noahportnoy/team-otto/website/Original/images/skiing.jpg

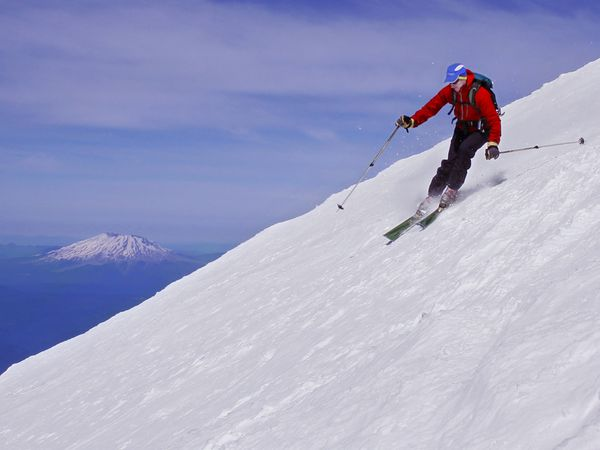
website/Original/images/skiing.jpg
