noahportnoy/team-otto/website/images/albion_png.png

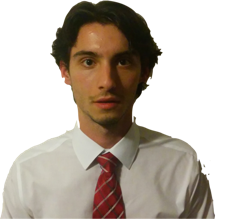
website/images/albion_png.png
