noahportnoy/team-otto/README.md

Team Otto
========

Otto - the personal Cameraman. 
-----------------------------

Otto is a drone that will follow and record you while performing action sports. Whether it be surfing, skiing, or mountain biking! Otto follows the user by fusing camera tracking data with GPS information from the user's smart phone and local GPS unit.

For more info visit: [Team Otto](http://www.ecs.umass.edu/ece/sdp/sdp15/team07/index.html)
