noahportnoy/team-otto/website/docs/Otto_MDR.pdf

# Midway Design Review

# Team Otto

November 25, 2014

# The Team

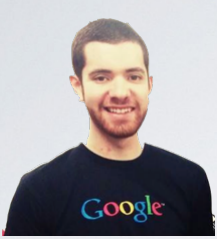
[picture p7: figure]
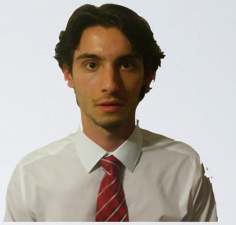
[picture p8: figure]

Noah Portnoy, CSE | Albion Lici, CSE

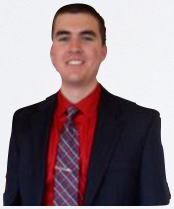
[picture p9: figure]
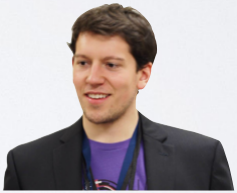
[picture p10: figure]

Seth Kielbasa, CSE | Andrew Sousa, EE

# Our System

Otto - The Personal Videographer
- Quadcopter for recording individual action sports
- Autonomous flight
- FollowMe (Tracking)

Evaluator Concerns
- Societal impact
- No collision avoidance or drone-drone communication
- What is different about Otto?

# System Requirements

### 1. Track user through a fusion of two sensors: GPS and camera 2. Collect GPS location of user with WiFi connection to user

device

### 3. Collect finer location data of user through camera tracking

4. Carry out user takeoff and landing commands
5. Maintain a user-defined drone/user separation distance
6. Allow user to start and stop video recording
7. Video recording is high-definition (720p or better)

### 8. Must maintain visual lock on user for duration of recording

9. Must take preliminary measures upon reaching critical battery level 10.Safety lock in hardware and software

# System Specifications

## 1. Maximum drone/user separation: 30 meters

## 2. Minimum drone/user separation: 5 meters 3. Average flight time: 10 minutes

## 4. Max velocity of drone: 30 mph 5. Max angular velocity of 1.8 rad/sec (103°/sec) 6. All-up mass must be less than 1.5 kg 7. Must lift at least 1.5 kg at 50% throttle

# Otto Block Diagram

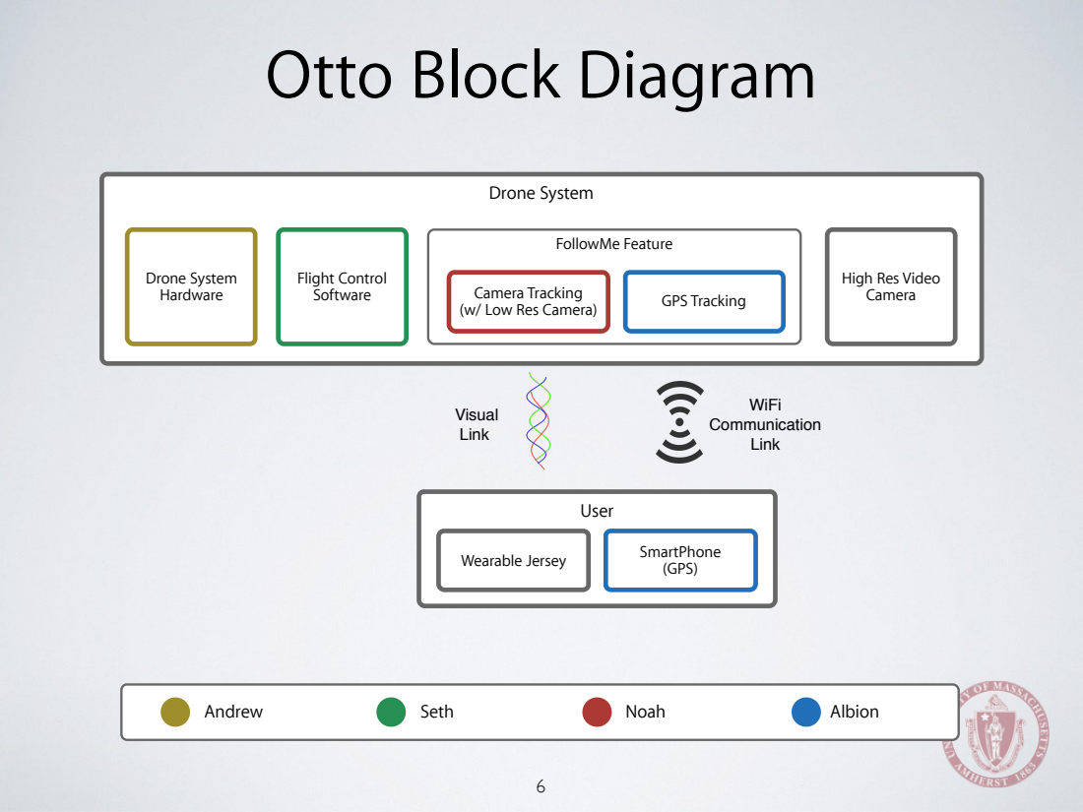
[picture p11: page 6]
User; Andrew; Seth; Noah; Albion; WiFi Communication Link; SmartPhone; Visual Link; Drone System; Flight Control Software; FollowMe Feature; Drone System Hardware

High Res Video
Camera

GPS Tracking Camera Tracking
(w/ Low Res Camera)

(GPS) Wearable Jersey

# Drone System Hardware - Data

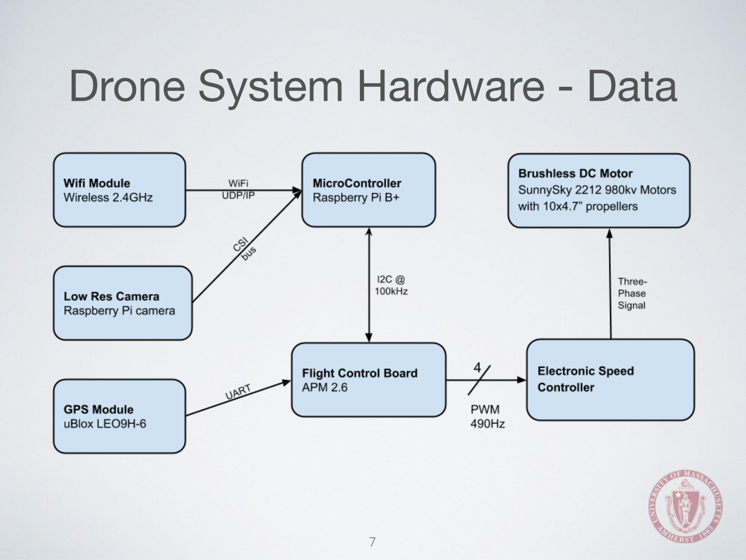
[picture p12: page 7]

# Drone System Hardware - Power

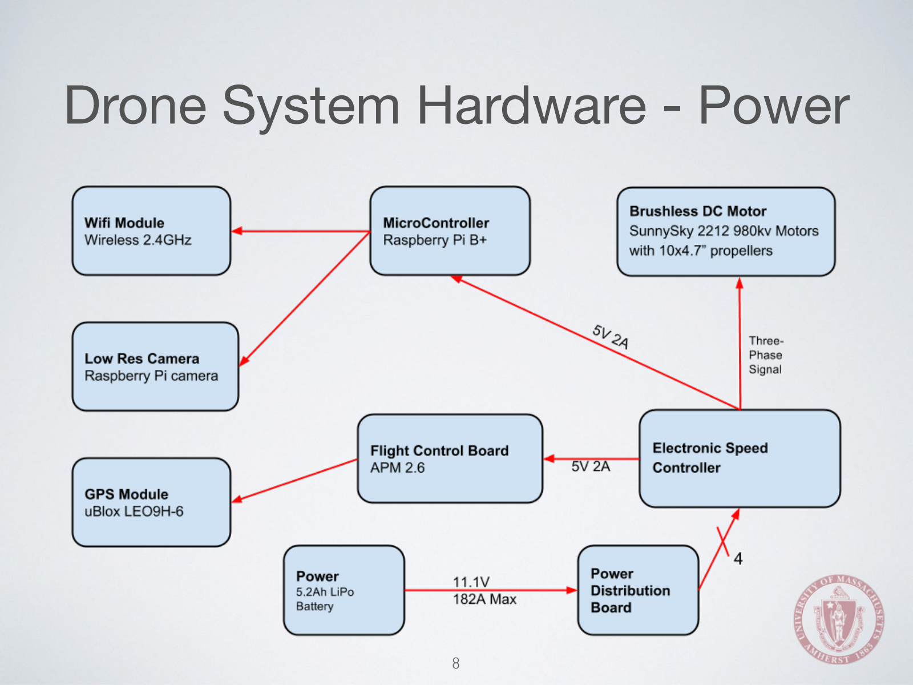
[picture p13: page 8]

# Drone System Hardware

## Requirements

## - Power system with 11.1V for 10 minutes - Must lift at least 1.5 kg at 50% throttle - Interface all devices together

## Accomplished

## - All of the above in prototype form

# Flight Control Software

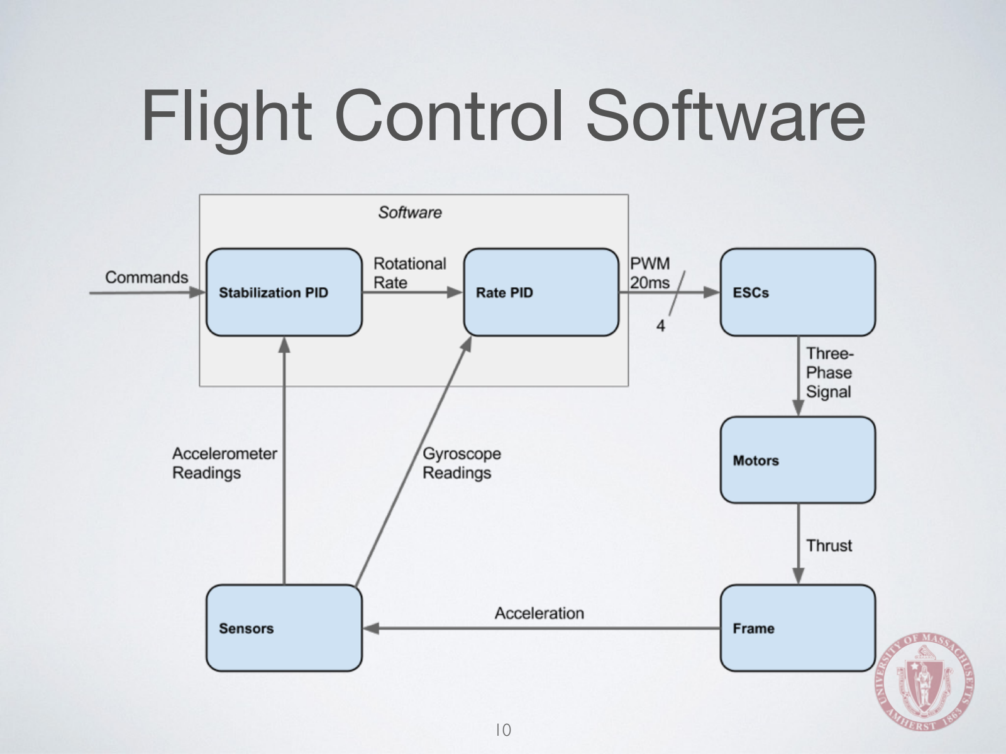
[picture p14: page 10]

# Flight Control Software

Requirements
- Read sensor data
- Feed flight control algorithm
- Send speed updates to ESCs

Accomplished
- Demonstrated ability to accurately read accelerometers and gyroscopes
- Implemented PID algorithm to make fast decisions on motor updates
- Successful test flights via manual RC control

# GPS Tracking

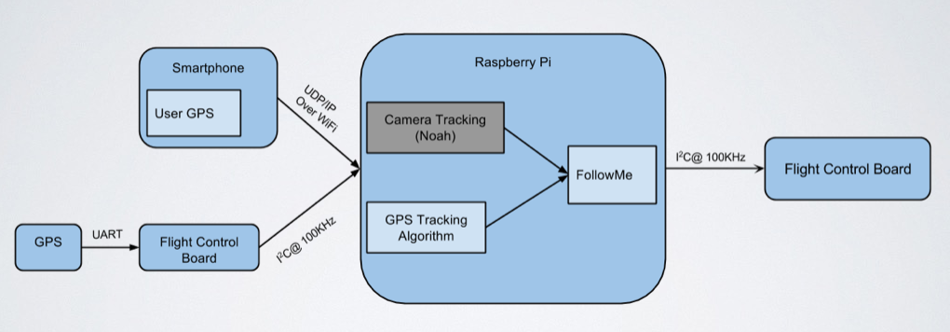
[picture p15: figure]

# GPS Tracking

Requirements
- GPS+WiFi module on drone and user’s smartphone
- WiFi running @ 2.4Ghz
- Maximum of 30 meter separation between the two WiFi modules

Accomplished
- Establish WiFi and I2C link
- Exchange coordinates between WiFi+I2C Link @ 2Hz
- Output separation between drone and user on smartphone

# Camera Tracking

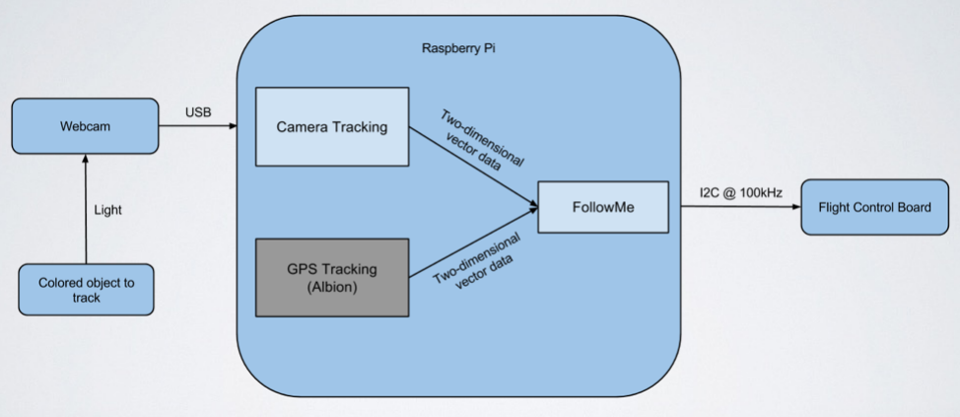
[picture p16: figure]

# Camera Tracking

Requirements
- Use low-resolution video camera
- Perform color-based object tracking
- Send commands to flight control software

Accomplished
- Color-based object tracking on Raspberry Pi
- Executes at 7.5 fps
- Detects when object is moving out of frame
- Sends yaw commands to servo to keep object in frame

# FollowMe Requirements

1. Synthesize GPS tracking and camera tracking inputs
2. Perform weighted average of inputs based on each system’s confidence metric
3. Output commands to flight control board over I2C
4. Visually lock onto user upon takeoff
5. Maintain visual lock on user for duration of recording

# CDR Deliverables

# Functional prototype

# - Autonomous flight - FollowMe Feature - Record user

# Timeline

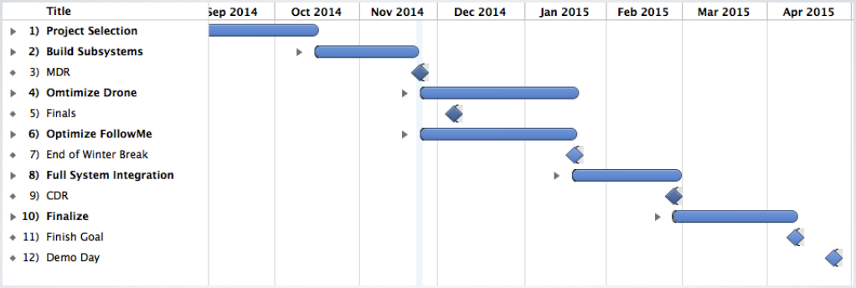
[picture p17: figure]

# Timeline

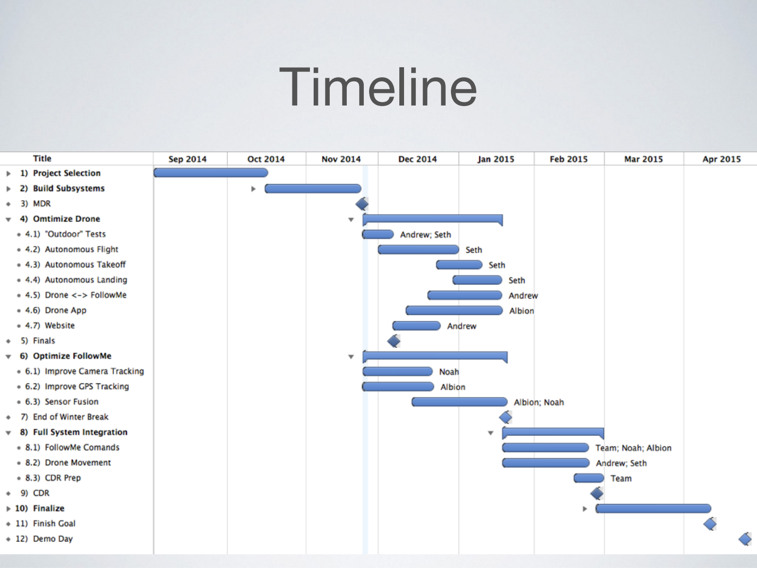
[picture p18: page 19]

# Demonstration

# Build Drone Flight Algorithm GPS Tracking Camera Tracking

# Build Drone Flight Algorithm GPS Tracking Camera Tracking

Thank you.

# Questions?

# Backup Slides

# Societal Impact

Positive | Negative
Ability to have a unique aerial 3rd person view of yourself | Could capture other people in recordings (without their knowledge of who the drone belongs to)
Ability to be followed by a quadcopter which could execute task for you | “Bad guys” could use this technology to follow people (could be discreet; could use GPS from phone)
Image processing on our system enables excellent tracking of user | Technology could be used to locate and track certain people (who do not want to be located)
This product will open our eyes to the many possibilities of what drones can do | “Bad guys” could use our platform for invasion of privacy, or even physical attacks
Technology could be leveraged in other areas such as medical, military, etc. | Could be used maliciously in a military or medical context

# Stretch Goals

## - Live video feed - Camera tracking, no wearable jersey required - Stabilize camera with a gimbal - Obstacle avoidance - Backwards recording

# Collision Avoidance

- Infrared Receivers
- Not a great option
- Earth’s surface receives IR energy from the sun
- Unreliable due to operating environment
- Ultrasonic sensors
- Maxbotix Sonar Range Finder
- Range: 0 - 21ft
- Price: 25 each
- http://www.pololu.com/product/726/resources

# Drone-Drone Communication

## - Not considering the multi-user for our prototype

# Power

## - Battery - 5200mAh lipo - 35C = 35*5.2A = 182A of Const. Current - Max burst current = 70C = 364A

## - Battery Voltage: 11.1 < V < 12.3

## - BEC on ESC output 5V @ 2A max per ESC

# Angular Velocity

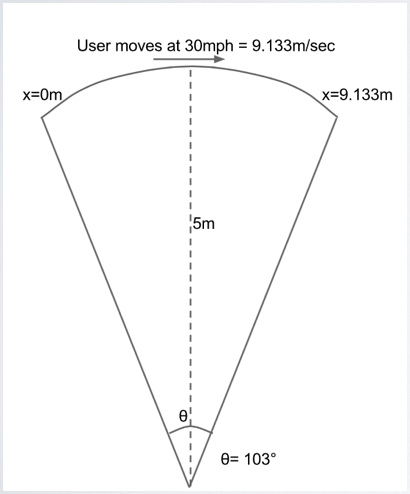
[picture p19: figure]

θ= length of subtended arc / radius

θ= 1.8 rad == 103°

⍵ = θ/t == 1.8 rad/sec

# Drone Hardware

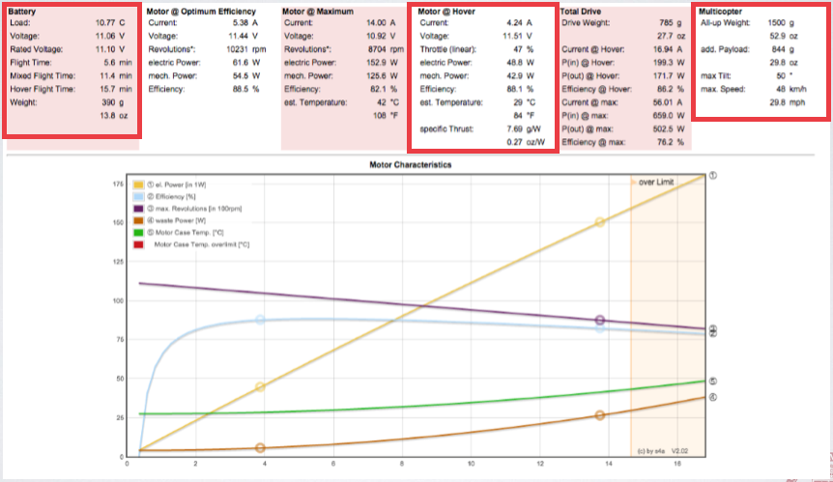
[picture p20: figure]

# Current Solution: AirDog

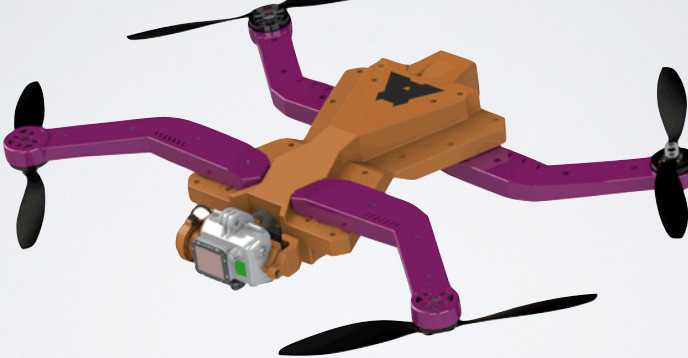
[picture p21: figure]

# Current Solution: Hexo+

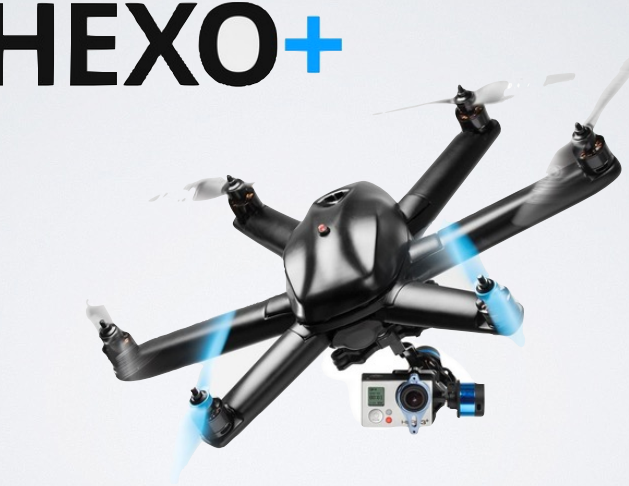
[picture p22: figure]

# Current Solution: Iris+

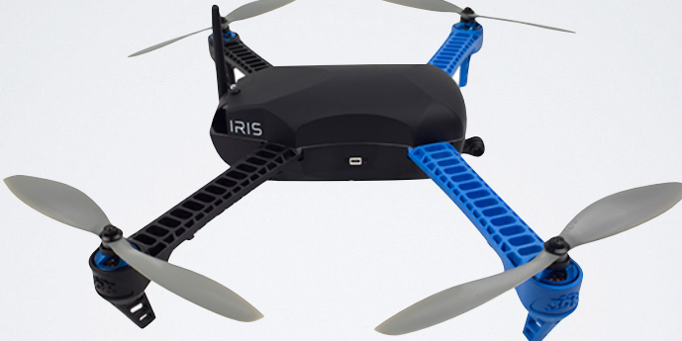
[picture p23: figure]

# Camera: GoPro Hero (2014)

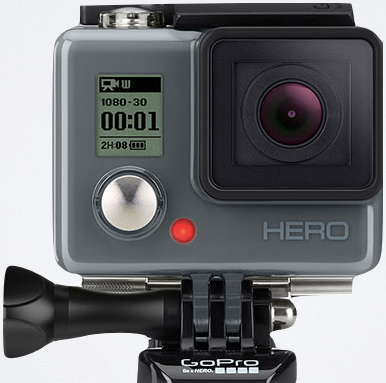
[picture p24: figure]

# Design Alternatives

## 1. Use long-range bluetooth instead of WiFi 2. Use a wearable device in place of a phone for tracking 3. Physical tether 4. Use a planned flight path in place of the FollowMe feature 5. Use a single camera for both tracking and recording

Noah Portnoy
SDP 15 - Team Otto
10/7/14
Wi-Fi Signal

Strength

in

the

Quad, using Acrylic

Wi-Fi

Free

### 2.4 GHz Spectrum

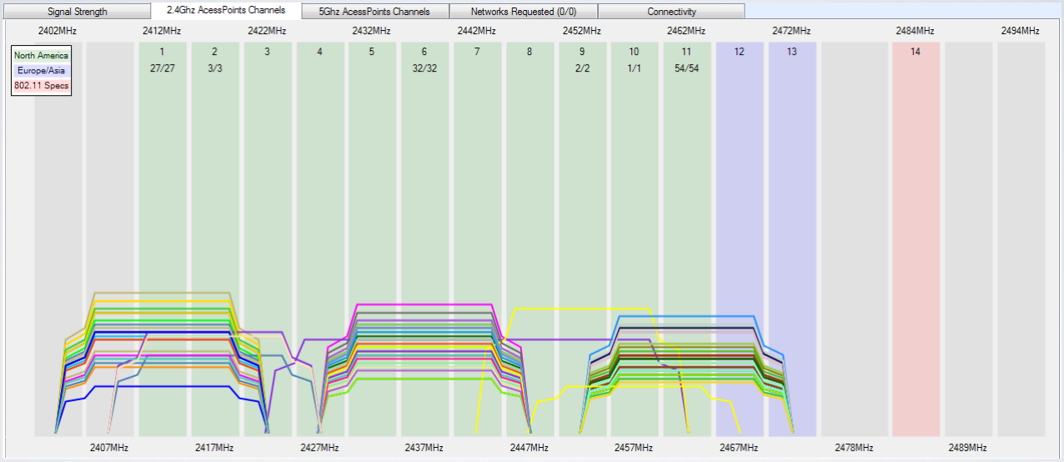
[picture p25: figure]

Color indicates a unique broadcast. Band height indicates signal strength (RSSI) in dBm.

129 unique broadcasts in the 2.4 GHz spectrum (65.8% of total broadcasts)
Max RSSI for all broadcasts: -64 dBm
Min RSSI for all broadcasts: -88 dBm

### 5 GHz Spectrum

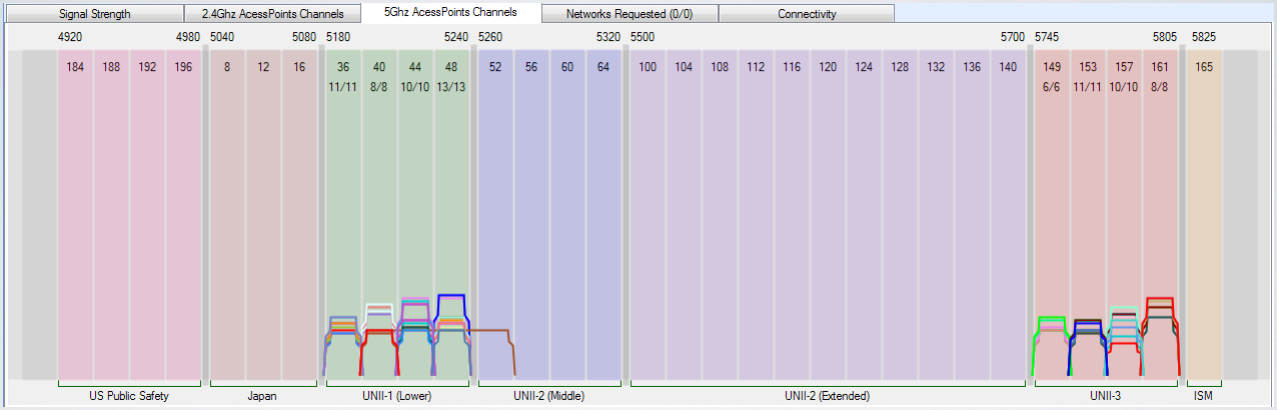
[picture p26: figure]

Color indicates a unique broadcast. Band height indicates signal strength (RSSI) in dBm.

65 unique broadcasts in the 5 GHz spectrum (33.2% of total broadcasts)
Max RSSI for all broadcasts: -75 dBm
Min RSSI for all broadcasts: -90 dBm

# Drone Weight & Payload

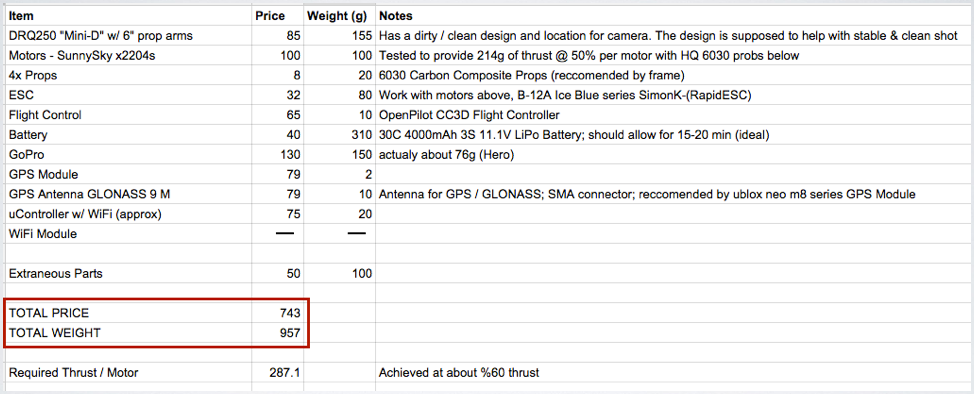
[picture p27: figure]

# Current Financial Standing

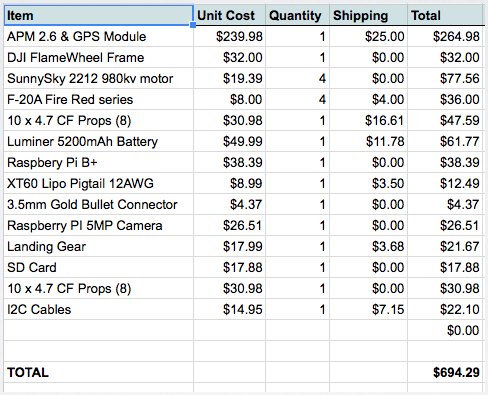
[picture p28: figure]
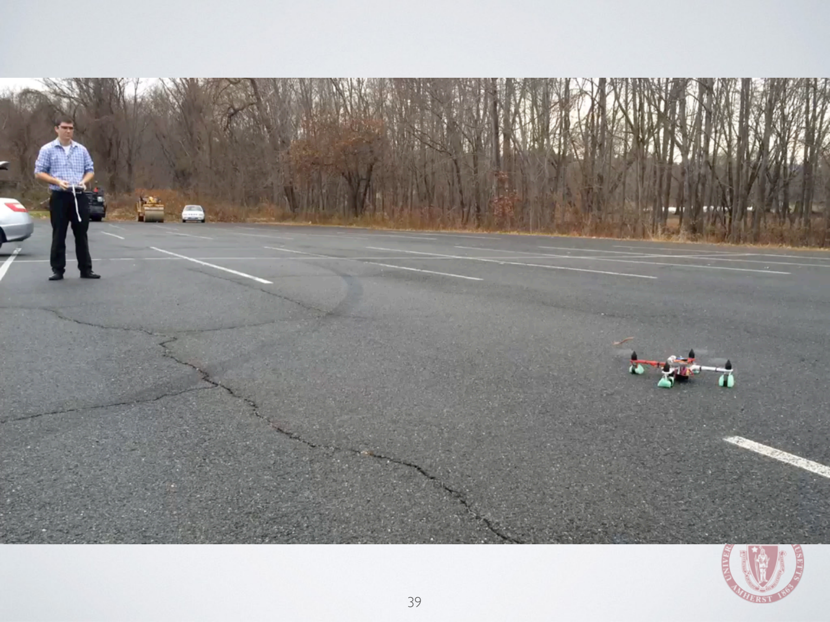
[picture p29: page 39]
