noahportnoy/team-otto/website/images/albion.png

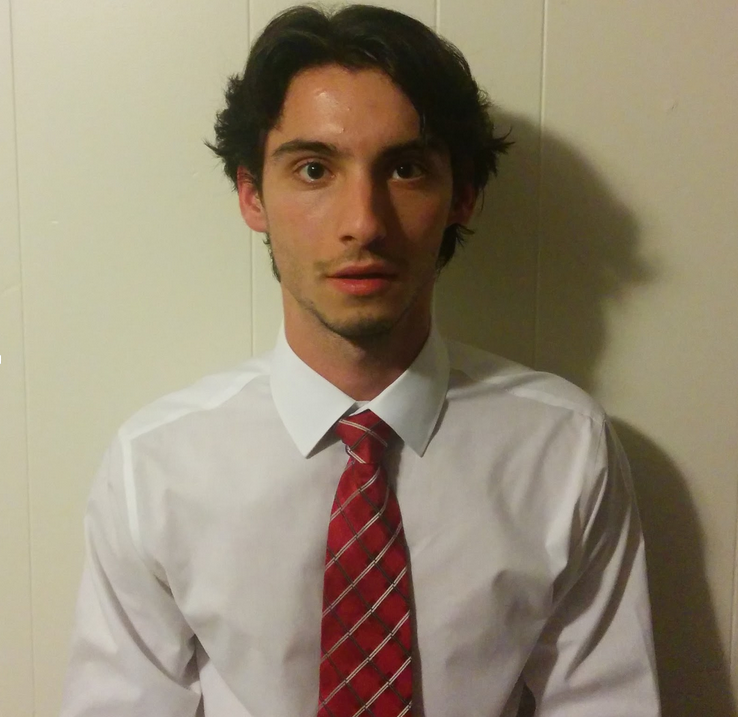
website/images/albion.png
