noahportnoy/team-otto/website/images/andrew.jpg

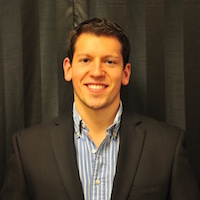
website/images/andrew.jpg
