noahportnoy/team-otto/website/images/biking.jpg

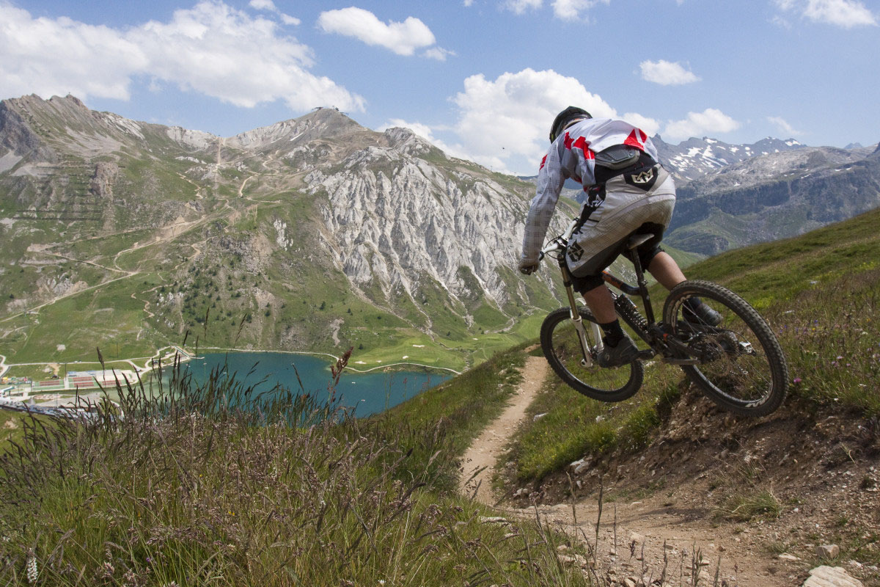
website/images/biking.jpg
