noahportnoy/team-otto/website/images/noah.png

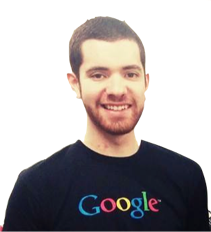
website/images/noah.png
