noahportnoy/team-otto/website/images/running.jpg

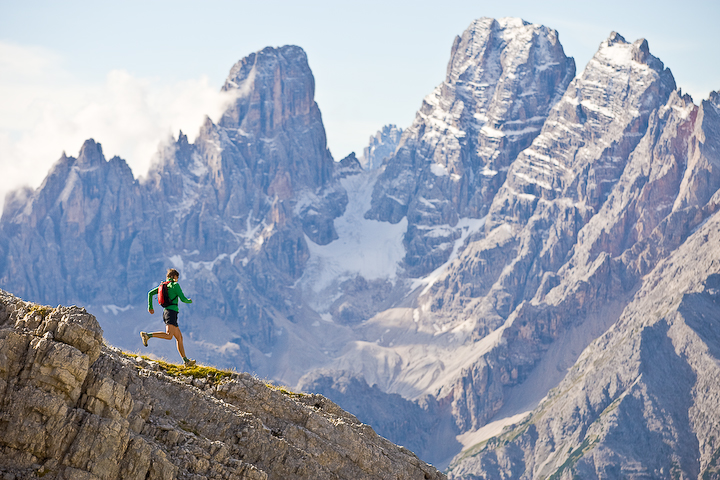
website/images/running.jpg
