noahportnoy/team-otto/website/images/seth.png

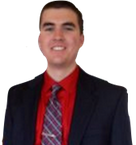
website/images/seth.png
