noahportnoy/team-otto/website/images/snowboarder.jpg

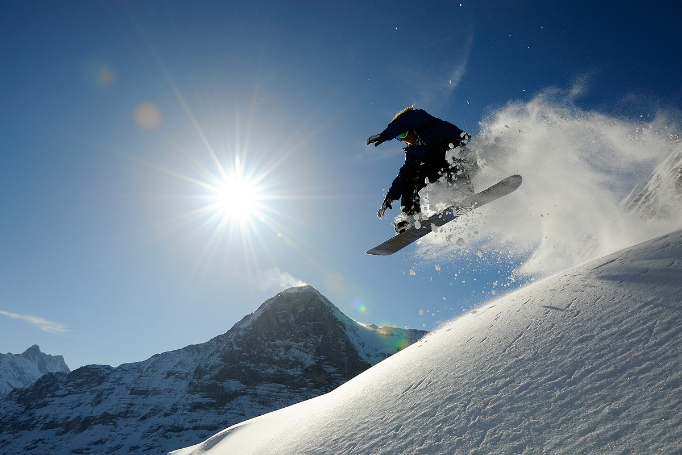
website/images/snowboarder.jpg
