noahportnoy/team-otto/website/images/surfing.jpg

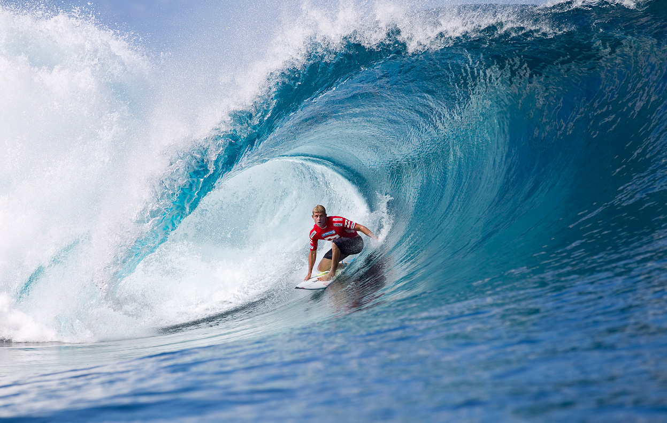
website/images/surfing.jpg
