noahportnoy/team-otto/flight/recalibration.txt

TODO:
- Ask Andrew to reinstall Raspberry Pi, rotate main plate, tidy up wiring, and let me know the new motor mapping
- Put props on the correct motors
- Observe the rcthr value needed for hover on the phone, and use that against our 1340 to determine the necessary scaling factor
- Ensure that a SW calibration for 1107-1600 works the same as the ESC calibration did

calibration min/max	| PID_GAIN 		| origin of min/max	| calibration performed	| results
--------------------|---------------|-------------------|-----------------------|--------------------------------------------
1100 - 1350 		| 3.2 			| old code			|						| 
1107 - 1400 		| 2.7304		| old code			|						| 
1107 - 1500 		| 2.0356		| old code			| ESC calibration		| uncontrollable
1107 - 1600 		| 1.3491		| guess				| ESC calibration		| promising but somewhat difficult to control
1107 - 1600 		| 1.3491		| guess				| SW calibration		| ??
1107 - 1700 		| 1.3491		| old code			|						| 
1100 - 1800 		| 1.1429		| old code			|						| 

––––––––––––––––––––––––––––––––––––––––––––––––––––––––––––––––––––––––––––––––––––––––––––––––––––––––––––––––––––––––––––––––––––––––––––––––
1107 - 1600 		| n/a 			| previous test 	| ESC Calibration 		| On Rig: The I term isn't strong enough to drive Otto back to place
1107 - 1550 		| n/a 			| based on prev 	| ESC Calibration 		| On Rig: Much more responsive to roll commands than the 1600 max calibration.
1107 - 1510 		| n/a 			| previous			| ESC Calibration 		| Even more responsive to roll commands (on the rig). Experienced a successful, flight with this calibration. Hover thr == 1363 for this test.
1107 - 1550 		| n/a 			| previous 	 		| ESC Calibration 		| Flight: A bit more unstable (especially in yaw, it kept rotating by itself).
1107 - 1500 		| n/a 			| previous			| ESC Calibration 		| Flight: A bit better than the 1550 version. Hovers around 1563 Video on Google Drive.
1107 - 1480 		| n/a 			| previous			| ESC Calibration 		| Flight: A bit better than the 1500 test. This was an attempt to get the hover throttle to ~1340 but battery died on me. Seems to want to constantly pitch, roll, and yaw in one direction (presumably Feedback control issues). Hover thr == 1344 (full battery)
1107 - 1460			| n/a 			| previous trial	| ESC calibration 		| Flight: flys well under manual control

––––––––––––––––––––––––––––––––––––––––––––––––––––––––––––––––––––––––––––––––––––––––––––––––––––––––––––––––––––––––––––––––––––––––––––––––
1107 - 1460 		| n/a 			| previous test 	| ESC Calibration 		| Flight: flys well in manual. When in auto_alt_hold Otto makes some odd sounds as if some pistons are changing too quickly.
1107 - 1460 		| n/a 			| previous test 	| SW Calibration 		| Worked in approx the same way as previous (qualitatively)
1100 - 1460 		| n/a 			| previous test 	| SW Calibration 		| Flight: Alt_hold seemed smoother than 1107-1460
