noahportnoy/team-otto/(commit log)

2014-11-13 Moved all flight code to flight/; added working camera code to camera/
2014-11-13 Adding safety button test
2014-11-13 added safety switch to rc controller
2014-11-15 Fixed scaling bug; running on Raspberry Pi
2014-11-16 Added Compass integration for yaw issue
2014-11-21 Version 2.5
    Solution for yaw problem. Testing okay via console outputs. Untested on
    drone. DO NOT FLY.
    [consoleInputTest.ino]
2014-11-23 Added framerate calculation; working servo control through Arduino
2014-11-25 added green hsv range, currently unused
2015-01-25 Added library & UART0 Test
2015-01-27 updated APM UART code
2015-01-28 Create GPS_ublox.ino
    UART code to read GPS data from GPS Ublox modules + i2c to communicate with rpi
2015-01-29 Added test.py to improve the accuracy of camera tracking
2015-01-30 Reorganized camera files; added video recorder
2015-02-03 added F.Mode switch & changes to alt hold
2015-02-07 tuned PID's and added heading control.
2015-02-13 Fixed flight.ino; now works with latest autonomous takeoff
    [flight.ino]
2015-02-13 fixed heading hold & added GPS hold SW
    [flight.ino]
2015-02-16 merged w/ master & fixed spinning prop issue
    [flight.ino]
2015-02-16 Fixed issues for master pull request
    [flight.ino]
2015-02-17 Adding land function. Still has no way to switch into autonmous land from altitude hold
2015-02-18 Adjusting hover throttle based on battery level, expanded usage of heading hold, updated PIDs, and fixed GPS bug
    [flight.ino]
2015-02-20 Disabled gps lock req on startup; a couple formatting changes
2015-02-20 Implemented more send to phone functions. Changed buffer size for messaging uart from 16 to 32. Added send to phone functions in the flight code
2015-02-20 Fix for sending processed climb rate to phone
    [flight.ino]
2015-02-21 Adjusted ALT_STAB pid; adjusted hover throttle
2015-02-25 Untested: fixes for heading hold
    [flight.ino]
2015-02-26 Latest PID values for alt hold
2015-02-26 More fixes from sanity tests
    [flight.ino]
2015-02-28 Kinda working GPS tracking, no oscillations
    [flight.ino]
2015-02-28 Added some kP to PITCH and ROLL_CMD; seems to be chasing a given target
2015-03-01 Improved GPS accuracy; fixed rcpit and rcroll issues in gpsTracking
    [flight.ino]
2015-03-01 Commented out print statements in flight loop
2015-03-01 Tuned PITCH_CMD and ROLL_CMD kP down to 0.4; seeing oscillations sometimes; discovered heading inaccuracies
    [flight.ino]
2015-03-02 Added potential compass heading fix, must be flight tested
    [flight.ino]
2015-03-02 Fixed compass heading; rcpit and rcroll look good; must be flight tested
    [flight.ino]
2015-03-02 Minor print statement changes; added 0 rcpit and rcroll during autonomousTakeoff
2015-03-03 Modified motor mappings for new setup with 3DR ESCs
2015-03-26 Updated motor mapping; added esc calibration options
2015-03-26 Expanded and cleaned up calibration options
2015-03-27 More additions to and fixes for calibration options; add calibration documentation
    [flight.ino]
2015-03-27 Eliminated ESC calibration that couldn't have worked (sanity check)
2015-04-02 ESC calibration & alt_hold verification
2015-04-07 heading track and calibration in boyden
2015-04-10 Code rewrite/cleanup; disabled printouts from uartMessaging
2015-04-10 Minor cleanup of definitions, gps target, and pid array
2015-04-11 Split code into multiple files; needs testing
    [climb_rate.xlsx]
2015-04-12 Removed extra file
    [climb_rate.xlsx]
2015-04-12 Added throttle assistance + fix for autonomousTakeoff
    [control.ino, flight.ino, motors.ino, sensors.ino, state.ino]
2015-04-14 functional bearing feature
2015-04-15 Enabled gps tracking when 'outdoors'; added battery voltage averaging
2015-04-15 Trying to fix drift from roll to pitch
    [flight.ino, setup.ino]
2015-04-15 Working phone takeoff functionality in no-motors test
2015-04-15 updates to bearing function
2015-04-15 fixed merge w/ master
    [sensors.ino]
2015-04-15 Fix to weed out inaccurate drone coordinates
    [control.ino, flight.ino, gps.ino]
2015-04-15 Attempting to improve pitch/roll, needs testing
2015-04-16 Trim pitch/roll seems to fix pitch roll 0 issue
    [flight.ino, sensors.ino, setup.ino]
2015-04-16 Fixed desired bearing issue
    [control.ino, flight.ino, sensors.ino, state.ino, uart.ino]
2015-04-16 Switched state back to original form
2015-04-16 GPS tracking works in no-motors tests
2015-04-16 Added sendBearing and sendSeperationDistance to the UartMessaging library
2015-04-16 Added land functionality from phone; disabled bearing for now
2015-04-16 Added functionality works in no-motors tests
2015-04-23 Rolled back land + added fix for indeterminate state
    [control.ino, flight.ino]
2015-04-23 improved bearing and seperation distance 4/23
2015-04-23 First no-motors test
2015-04-24 Turned PRINT_DEBUG off (woops), went back to gps 2d lock
